berfinkokmen/Temperature-Control-in-a-Miniaturized-Heating-Process/figures/P_controller_wo_onoff.png

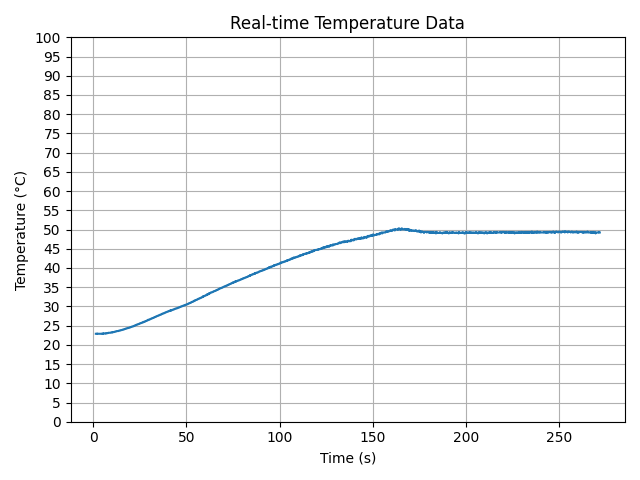
figures/P_controller_wo_onoff.png
