berfinkokmen/Temperature-Control-in-a-Miniaturized-Heating-Process/figures/PI_controller_wo_onoff_oscilliations.png

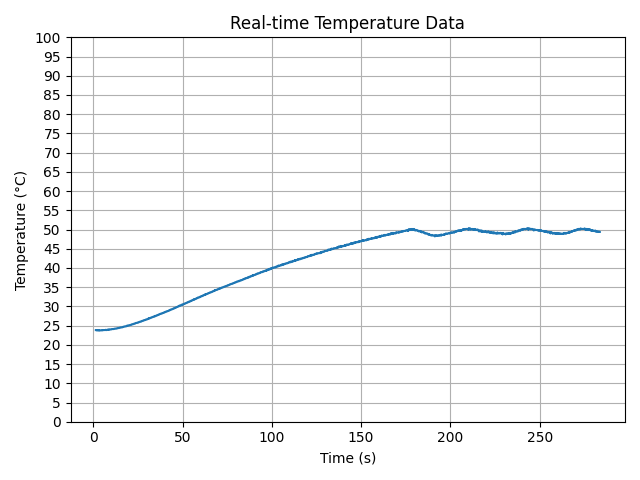
figures/PI_controller_wo_onoff_oscilliations.png
