berfinkokmen/Temperature-Control-in-a-Miniaturized-Heating-Process/figures/PID_controller_onoff.png

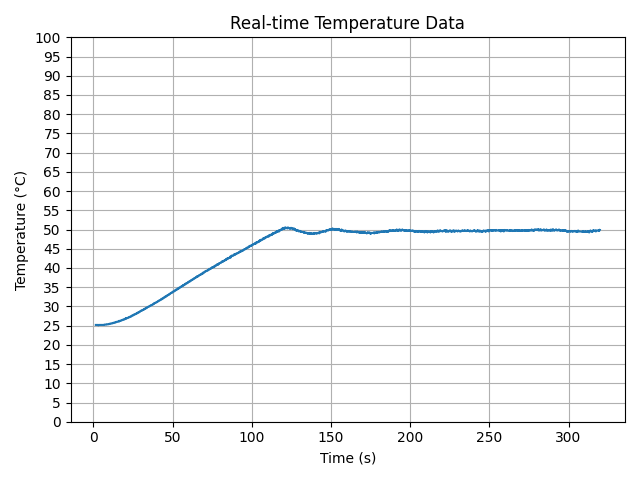
figures/PID_controller_onoff.png
