berfinkokmen/Temperature-Control-in-a-Miniaturized-Heating-Process/figures/PID_controller_wo_onoff_oscilliations.png

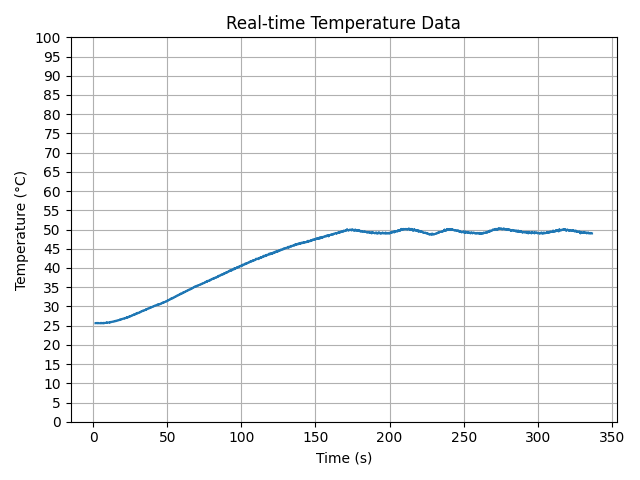
figures/PID_controller_wo_onoff_oscilliations.png
